liyunyi1936/foc/image/wheel.png

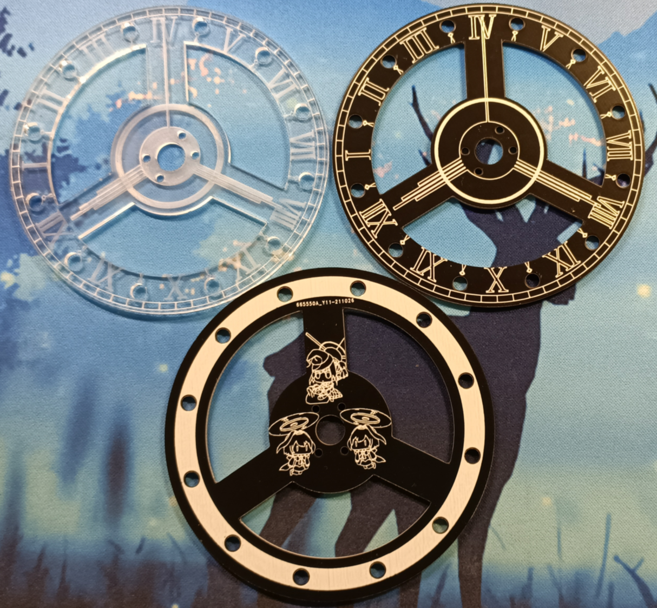
image/wheel.png
