liyunyi1936/foc/v2/BOM_SMT购买专用_莱洛三角V2.csv

ID | Name | Designator | Footprint | Quantity | Manufacturer Part | Manufacturer | Supplier | Supplier Part | Price
1 | M1010RS-03P | CN2 | CONN-SMD_M1010RS-03P | 1 | M1010RS-03P | XFCN(台湾兴飞) | LCSC | C541845 | 0.6462
2 | FR107_C2760867 | D4,D5,D6 | SOD-123FL_L2.7-W1.8-LS3.8-RD | 3 | FR107 | Slkor(萨科微) | LCSC | C2760867 | 0.067
3 | SMF5.0A_C908213 | D7 | SOD-123FL_L2.7-W1.8-LS3.8-RD | 1 | SMF5.0A | FUXINSEMI | LCSC | C908213 | 0.2007
4 | SJD12C6.5L01 | D8 | SOD-123_L2.8-W1.8-LS3.7-BI | 1 | SJD12C6.5L01 | Brightking Elec (TAIWAN) | LCSC | C313294 | 0.2679
5 | K2-3.6×6.1_SMD | KEY1,KEY2 | KEY-SMD_2P-L6.2-W3.6-LS8.0 | 2 | K2-1107ST-A4SW-06 |  | LCSC | C118141 | 0.4502
6 | 6.8uH | L1 | IND-SMD_L6.0-W6.0_SWPA6045S | 1 | SWPA6045S6R8MT | Sunlord | LCSC | C57254 | 0.5901
7 | 33uH | L2 | IND-SMD_L7.1-W6.6 | 1 | SLO0630H330MTT | Sunltech Tech | LCSC | C207844 | 0.737
8 | SK-12D02-VG5 | SW1 | SW-TH_SK-12D02-VG5 | 1 | SK-12D02-VG5 | Rectangular Connectors - Contacts | LCSC | C136722 | 0.5276
9 | CN3300 | U2 | SOT-23-6_L2.9-W1.6-P0.95-LS2.8-BL | 1 | CN3300 | CONSONANCE | LCSC | C52375 | 1.7574
10 | EG2133 | U7 | TSSOP-20_L6.5-W4.4-P0.65-LS6.4-BL | 1 | EG2133 | EG Micro | LCSC | C190343 | 1.95
11 | CM1010-A | U8,U9,U10 | SOT-23-6_L2.9-W1.6-P0.95-LS2.8-BR | 3 | CM1010-A | iCM(创芯微) | LCSC | C2685539 | 1.1691
12 | TYPE-603-T3 | USB1 | USB-C-SMD_TYPE-603-T3 | 1 | TYPE-603-T3 | Yuandi(台湾元迪) | LCSC | C2689837 | 0.505
13 | 47uF | C4,C7,C17 | CAP-SMD_BD5.0-L5.3-W5.3-RD | 3 | CS1C470M-CRD54 | SEMTECH | LCSC | C96178 | 0.1769
14 | AP2300 | Q1,Q3,Q4,Q5,Q6,Q7,Q8,Q9,Q10,Q11 | SOT-23-3_L2.9-W1.6-P1.90-LS2.8-BR | 10 | AP2300 | ALLPOWER(铨力) | LCSC | C360338 | 0.163056
