liyunyi1936/foc/v2/BOM_莱洛三角V2.csv

ID | Name | Designator | Footprint | Quantity | Manufacturer Part | Manufacturer | Supplier | Supplier Part | Price
1 | 22UF | C1,C14 | C0805 | 2 | CL31A226KPHNNNE | SAMSUNG | LCSC | C5672 | 0.2392
2 | 100nF | C2,C5,C6,C13,C16,C21,C22,C23,C24,C25,C26,C27,C28,C29,C30,C31,C32,C33,C34,C35,C36,C37,C38,C39,C40,C41,C42,C46,C47,C48 | C0603 | 30 | CC0603KRX7R9BB104 | YAGEO | LCSC | C14663 | 0.0154
3 | 1uF | C3,C15,C44 | C0603 | 3 | CL10A105KB8NNNC | SAMSUNG | LCSC | C15849 | 0.0331
4 | 47uF | C4,C7,C17 | CAP-SMD_BD5.0-L5.3-W5.3-RD | 3 | CS1C470M-CRD54 | SEMTECH | LCSC | C96178 | 0.1757
5 | 10nF | C8,C11,C12 | C0603 | 3 | 0603B103K500NT | FH | LCSC | C57112 | 0.0155
6 | 1nF | C9 | C0603 | 1 | CL10B102KB8NNNC | SAMSUNG | LCSC | C1588 | 0.0162
7 | 47pF | C10 | C0603 | 1 | CL10C470JB8NNNC | SAMSUNG | LCSC | C1671 | 0.0314
8 | 4.7uF | C43 | C0603 | 1 | CL10A475KO8NNNC | SAMSUNG | LCSC | C19666 | 0.0657
9 | 22pF | C45 | C0603 | 1 | CL10C220JB8NNNC | SAMSUNG | LCSC | C1653 | 0.0321
10 | M1010RS-03P | CN2 | CONN-SMD_M1010RS-03P | 1 | M1010RS-03P | XFCN(台湾兴飞) | LCSC | C541845 | 0.6462
11 | SS34_C8678 | D1,D3 | DO-214AC_L4.3-W2.7-LS5.3-RD | 2 | SS34 | MDD | LCSC | C8678 | 0.2931
12 | ZMM3V3 | D2 | LL-34_L3.5-W1.5-RD | 1 | ZMM3V3 | SEMTECH | LCSC | C8056 | 0.13
13 | FR107_C2760867 | D4,D5,D6 | SOD-123FL_L2.7-W1.8-LS3.8-RD | 3 | FR107 | Slkor(萨科微) | LCSC | C2760867 | 0.067
14 | SMF5.0A_C908213 | D7 | SOD-123FL_L2.7-W1.8-LS3.8-RD | 1 | SMF5.0A | FUXINSEMI | LCSC | C908213 | 0.2007
15 | SJD12C6.5L01 | D8 | SOD-123_L2.8-W1.8-LS3.7-BI | 1 | SJD12C6.5L01 | Brightking Elec (TAIWAN) | LCSC | C313294 | 0.2679
16 | 1N4148W_C81598 | D9,D10,D11,D12,D13,D14 | SOD-123F_L2.7-W1.6-LS3.8-RD | 6 | 1N4148W | SEMTECH | LCSC | C81598 | 0.0761
17 | K2-3.6×6.1_SMD | KEY1,KEY2 | KEY-SMD_2P-L6.2-W3.6-LS8.0 | 2 | K2-1107ST-A4SW-06 |  | LCSC | C118141 | 0.4502
18 | 6.8uH | L1 | IND-SMD_L6.0-W6.0_SWPA6045S | 1 | SWPA6045S6R8MT | Sunlord | LCSC | C57254 | 0.5901
19 | 33uH | L2 | IND-SMD_L7.1-W6.6 | 1 | SLO0630H330MTT | Sunltech Tech | LCSC | C207844 | 0.737
20 | 19-217/BHC-ZL1M2RY/3T | LED1,LED2,LED3,LED4,LED5,LED27,LED28,LED29 | LED0603-R-RD | 8 | 19-217/BHC-ZL1M2RY/3T | EVERLIGHT | LCSC | C72041 | 0.1116
21 | AP2300 | Q1,Q3,Q4,Q5,Q6,Q7,Q8,Q9,Q10,Q11 | SOT-23-3_L2.9-W1.6-P1.90-LS2.8-BR | 10 | AP2300 | ALLPOWER(铨力) | LCSC | C360338 | 0.163056
22 | S8050_C2146 | Q2,Q12 | SOT-23-3_L3.0-W1.7-P0.95-LS2.9-BR | 2 | S8050 | CJ | LCSC | C2146 | 0.129
23 | 120 | R1,R2 | R0603 | 2 | 0603WAF1200T5E | UniOhm | LCSC | C22787 | 0.0081
24 | 62K | R3,R5 | R0603 | 2 | 0603WAF6202T5E | UniOhm | LCSC | C23221 | 0.0074
25 | 56K | R4 | R0603 | 1 | 0603WAF5602T5E | UniOhm | LCSC | C23206 | 0.0077
26 | 10K | R6,R7,R9,R10,R11,R14,R15,R20,R21,R22,R23,R24,R30,R31,R32,R33,R40,R41,R47,R48,R49 | R0603 | 21 | 0603WAF1002T5E | UniOhm | LCSC | C25804 | 0.0073
27 | 27K | R8 | R0603 | 1 | 0603WAF2702T5E | UniOhm | LCSC | C22967 | 0.0077
28 | 1K | R12,R26,R28,R29 | R0603 | 4 | 0603WAF1001T5E | UniOhm | LCSC | C21190 | 0.0064
29 | 4.7K | R13,R34,R35 | R0603 | 3 | 0603WAF4701T5E | UniOhm | LCSC | C23162 | 0.0081
30 | 0.1 | R16 | R1206 | 1 | 1206W4F100LT5E | UniOhm | LCSC | C25334 | 0.0573
31 | 470 | R17,R18,R19 | R0603 | 3 | 0603WAF4700T5E | UniOhm | LCSC | C23179 | 0.0074
32 | 22Ω | R25,R27,R50 | R1206 | 3 | 1206W4F220JT5E | UniOhm | LCSC | C17958 | 0.0258
33 | 10Ω | R36,R42,R43,R44,R45,R46 | R0603 | 6 | 0603WAF100JT5E | UniOhm | LCSC | C22859 | 0.0078
34 | 300 | R37,R51 | R0603 | 2 | 0603WAF3000T5E | UniOhm | LCSC | C23025 | 0.0073
35 | 1.2K | R38 | R0603 | 1 | 0603WAF1201T5E | UniOhm | LCSC | C22765 | 0.0077
36 | 11K | R39 | R0603 | 1 | 0603WAF1102T5E | UniOhm | LCSC | C25950 | 0.0098
37 | SK-12D02-VG5 | SW1 | SW-TH_SK-12D02-VG5 | 1 | SK-12D02-VG5 | Rectangular Connectors - Contacts | LCSC | C136722 | 0.5276
38 | TPS54331DR | U1 | SOIC-8_L5.0-W4.0-P1.27-LS6.0-BL-EP | 1 | TPS54331DR | TI | LCSC | C9865 | 2.3
39 | CN3300 | U2 | SOT-23-6_L2.9-W1.6-P0.95-LS2.8-BL | 1 | CN3300 | CONSONANCE | LCSC | C52375 | 1.7574
40 | AMS1117-3.3 | U5 | SOT-223-3_L6.5-W3.4-P2.30-LS7.0-BR | 1 | AMS1117-3.3 | AMS | LCSC | C6186 | 0.9989
41 | EG2133 | U7 | TSSOP-20_L6.5-W4.4-P0.65-LS6.4-BL | 1 | EG2133 | EG Micro | LCSC | C190343 | 1.95
42 | CM1010-A | U8,U9,U10 | SOT-23-6_L2.9-W1.6-P0.95-LS2.8-BR | 3 | CM1010-A | iCM(创芯微) | LCSC | C2685539 | 1.1691
43 | TYPE-603-T3 | USB1 | USB-C-SMD_TYPE-603-T3 | 1 | TYPE-603-T3 | Yuandi(台湾元迪) | LCSC | C2689837 | 0.505
44 | 22uF | C18,C19,C20 | C0603 | 3 | CL10A226MQ8NRNC | SAMSUNG | LCSC | C59461 | 0.056
