liyunyi1936/foc/v2/淘宝购买.xlsx

商品名称 | 数量 | 价格 | 淘宝链接
ESP-WROOM-32 选ESP-WROOM-32模组 | 1 | 11.5 | https://item.taobao.com/item.htm?spm=a1z10.3-c-s.w4002-23633313809.19.3dfb546e6TpzCy&id=551532642694
MPU-6050模块 | 1 | 5.6 | https://item.taobao.com/item.htm?spm=a1z09.2.0.0.13962e8dMoPn2X&id=16630417522&_u=q1sddf3scdf9
AS5600磁编码器 | 1 | 7.3 | https://item.taobao.com/item.htm?spm=a1z09.2.0.0.13962e8dMoPn2X&id=622544987536&_u=q1sddf3sa81a
ch340G USB转TTL 下载器 | 1 | 3.05 | https://item.taobao.com/item.htm?spm=a1z10.3-c-s.w4002-23633313809.9.671f546eIWPZyu&id=17817178269
40脚2.54mm单排针 （颜色随意） | 1 | 0.1 | https://item.taobao.com/item.htm?spm=a1z10.3-c-s.w4002-23633313809.10.c412546e6Qs8yh&id=14591564405
2.54MM间距单排母 3P一个 4P一个（也可以买40P的自己剪） | 1 | 0.15 | https://item.taobao.com/item.htm?spm=a1z10.3-c-s.w4002-23633313809.13.6571546eNITJtV&id=15813904618
2.54MM 40P杜邦线 公对母 | 1 | 1.75 | https://item.taobao.com/item.htm?spm=a1z10.3-c-s.w4002-23633313809.11.5880546eZ9Ny5b&id=16412228723
电机可选型号为GB2204和2715无刷电机（强烈推荐2715平衡性能好）
GB2204无刷电机 | 1 | 4.8 | https://item.taobao.com/item.htm?spm=a1z10.3-c-s.w4002-5028031793.9.33327160LLxtbT&id=596506316013
钕铁硼高强磁 直流无刷电机 2715 航模云台电机 | 1 | 7.6 | https://item.taobao.com/item.htm?id=597027494849&ns=1&abbucket=17 (https://item.taobao.com/item.htm?spm=a230r.1.14.1.4b561ff98WXXd3&id=597027494849&ns=1&abbucket=17)
以下磁铁二选一购买
径向磁铁 6*3mm | 10 | 9.9 | https://item.taobao.com/item.htm?spm=a1z0d.6639537.1997196601.4.beda7484epF01m&id=596454786426
径向磁环 D6*D3*4 | 1 | 1.92 | https://item.taobao.com/item.htm?spm=a1z0d.6639537.1997196601.4.2e0e7484hGRPi2&id=656463127193
锂电池3.7v 602535 600毫安 （正负线可以直接焊PCB上） | 3 | 5 | https://item.taobao.com/item.htm?spm=a1z09.2.0.0.75532e8dnYo6W1&id=551668511973&_u=f1sddf3sea89
以下紧固件只需要拍一件（数量做一套所需的数量）
35mm-M3铜柱 使用3个 | 1 | 3 | https://detail.tmall.com/item.htm?id=17318980620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
M3六角螺帽 使用3个 | 1 | 1.64 | https://detail.tmall.com/item.htm?id=20955552239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
M3*6平头螺丝 使用3个 | 1 | 3.08 | https://detail.tmall.com/item.htm?id=15817242523&skuId=4912759730383
M1.6*4十字圆头螺丝螺 使用8个 | 1 | 2.42 | https://detail.tmall.com/item.htm?id=18236357036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
M5*8六角螺丝螺栓螺母套装 使用12个（螺丝+螺母+垫片） | 1 | 5.8 | https://detail.tmall.com/item.htm?id=593829755002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
WS2812B 5050RGB幻彩四脚内置驱动IC灯珠5V | 21 | 0.14 | https://item.taobao.com/item.htm?id=626235317413&ns=1&abbucket=17 (https://item.taobao.com/item.htm?spm=a230r.1.14.119.58de714ed7XBaN&id=626235317413&ns=1&abbucket=17)
