liyunyi1936/foc/(list of files, cad)

Other CAD files:
莱洛三角结构/V2动量轮图案.dxf
莱洛三角结构/V2-M5孔动量轮8cm.dxf
莱洛三角结构/V1动量轮8cm.dxf
莱洛三角结构/V1莱洛三角形10cm.dxf
