liyunyi1936/foc/(commit log)

2021-08-17 8.18完成udp通信发送mpu6050数据
    [base.dxf, triangle.dxf, wheel.dxf]
2021-08-24 优化逻辑
2021-08-24 参考代码
2021-08-24 8.24姿态拟合代码实现
2021-08-25 8.26直立完成
2021-09-16 实现wifi上传多个数据并显示 需要实现复选框checkbox
2021-09-26 9.27完成摇摆平衡，还需要调参数
2021-09-30 c++测试程序
2021-10-09 command完成
2021-10-11 command载入到芯片中
    [triangle_10.dxf, triangle_new.dxf]
2021-10-12 新板测试程序
2021-10-13 上位机调参
2021-10-15 上位机调参-滑条
2021-10-18 电压控制改为速度控制，已经完成自平衡
2021-11-01 checkbox功能完善
2021-11-01 wifi开关bug修复
2021-11-09 markdowm完善了一下，删除无用的文件
    [base.dxf, triangle_10.dxf, triangle_new.dxf]
2021-11-09 readme image
    [动量轮8cm.dxf, 时钟指针.dxf, 时钟花纹.dxf, 时钟边框.dxf, 物料清单.xlsx, 莱洛三角形10cm.dxf]
2021-11-29 物料清单修改11.29
    [物料清单.xlsx]
2021-12-05 第一次使用须知
2021-12-10 第一次下载不需要注释程序了
2021-12-10 修复了gui显示不全的问题
2021-12-14 上位机更新
2021-12-17 物料清单修改-12.17
    [物料清单.xlsx]
2021-12-18 修复验证bug，arduino程序极对数输入错误的问题，会造成电机无法运行
2021-12-21 上位机添加了调试模式，可以显示原始文本数据。更新了物料清单里面的电机购买链接
    [物料清单.xlsx]
2021-12-21 添加了调试模式，可以显示文本数据
2021-12-21 物料清单修改12.21
    [物料清单.xlsx]
2021-12-25 物料清单修改
    [物料清单.xlsx]
2021-12-30 添加了电机调试模式，可以测试电机能否正常运行。
2021-12-31 物料清单更新12.31，esp32芯片更换成信泰购买省一些邮费
    [物料清单.xlsx]
2022-01-01 新建 Beta
2022-01-01 重命名 arduino/Beta 为 arduino/Betas
2022-01-01 新建 V1_RGB
2022-01-01 重命名 arduino/Betas/V1_RGB 为 arduino/Betas/RGB_V1.1.1
2022-01-01 arduino环境
2022-01-01 自平衡莱洛三角形 RGB版 HW:Ver 1.5 FW:Ver 1.1.1
    RGB版本程序 https://gitee.com/muyan3000/RGBFOC 基于45°(https://gitee.com/coll45/foc/)程序修改
2022-01-01 删除文件 arduino/Betas/RGB_V1.1.1/data
2022-01-01 删除文件 arduino/Betas/RGB_V1.1.1/Command.cpp
2022-01-01 删除文件 arduino/Betas/RGB_V1.1.1/Command.h
2022-01-01 删除文件 arduino/Betas/RGB_V1.1.1/Kalman.cpp
2022-01-01 删除文件 arduino/Betas/RGB_V1.1.1/Kalman.h
2022-01-01 删除文件 arduino/Betas/RGB_V1.1.1/i2c.ino
2022-01-01 删除文件 arduino/Betas/RGB_V1.1.1/main.ino
2022-01-01 新建 main
2022-01-01 自平衡莱洛三角形 RGB版 HW:Ver 1.5 FW:Ver 1.1.1
    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
2022-01-01 update arduino/Betas/RGB_V1.1.1/readme.txt.
2022-01-02 删除文件 arduino/Betas/RGB_V1.1.1/main/data/teset.html
2022-01-02 update arduino/Betas/RGB_V1.1.1/main/data/index.html. 增加debug功能
2022-01-02 update arduino/Betas/RGB_V1.1.1/main/main.ino. 增加debug功能，方便webserver端查看调试信息
2022-01-02 update arduino/Betas/RGB_V1.1.1/main/data/index.html.
2022-01-03 update arduino/Betas/RGB_V1.1.1/main/main.ino.
2022-01-05 update arduino/Betas/RGB_V1.1.1/main/main.ino. SSID地址唯一化
2022-01-18 update arduino/Betas/RGB_V1.1.1/main/main.ino. 更改 return_voltage_value 算法
2022-02-21 新建 RGB_V1.2.1
2022-02-21 V2硬件的程序
2022-02-21 update arduino/Betas/RGB_V1.2.1/main.ino. 开机默认wifi关闭
2022-02-21 重命名 arduino/Betas/RGB_V1.2.1 为 arduino/Betas/RGB_V2.1.1
2022-02-21 update arduino/Betas/RGB_V2.1.1/main.ino. 修正LQR方法
2022-02-23 重命名 arduino/Betas/RGB_V1.1.1 为 arduino/Betas/RGB_V1.5.1
2022-02-23 重命名 arduino/Betas/RGB_V1.5.1 为 arduino/Betas/RGB_V1.5
2022-02-23 重命名 arduino/Betas/RGB_V2.1.1 为 arduino/Betas/RGB_V2
2022-02-23 update arduino/Betas/RGB_V1.5/main/main.ino.
2022-02-23 重命名 arduino/Betas/RGB_V1.5/readme.txt 为 arduino/Betas/RGB_V1.5/readme.md
2022-02-23 update arduino/Betas/RGB_V1.5/readme.md.
2022-02-23 删除文件 arduino/Betas/RGB_V2/data
2022-02-23 删除文件 arduino/Betas/RGB_V2/Command.cpp
2022-02-23 删除文件 arduino/Betas/RGB_V2/Command.h
2022-02-23 删除文件 arduino/Betas/RGB_V2/Kalman.cpp
2022-02-23 删除文件 arduino/Betas/RGB_V2/Kalman.h
2022-02-23 删除文件 arduino/Betas/RGB_V2/i2c.ino
2022-02-23 删除文件 arduino/Betas/RGB_V2/main.ino
2022-02-23 add arduino/Betas.
2022-02-23 update arduino/Betas/readme.md.
2022-02-23 删除文件 arduino/Betas/RGB_V1.5/readme.md
2022-03-15 V2版本更新，制作时需要打开对应V1\V2文件夹
    [动量轮8cm.dxf, 时钟指针.dxf, 时钟花纹.dxf, 时钟边框.dxf, 物料清单.xlsx, 莱洛三角形10cm.dxf]
2022-03-15 更新V2
    [BOM_SMT购买专用_莱洛三角V2.csv, BOM_莱洛三角V2.csv, V1动量轮8cm.dxf, V1莱洛三角形10cm.dxf, V2-M5孔动量轮8cm.dxf, V2动量轮图案.dxf, 淘宝购买.xlsx, 物料清单.xlsx]
2022-03-22 制作请点击对应的文件夹
    [淘宝购买.xlsx]
